Darijoo/Radargun/KiCad/Radargun.kicad_pcb

## KiCad design KiCad/Radargun.kicad_pcb (2026-06-18)

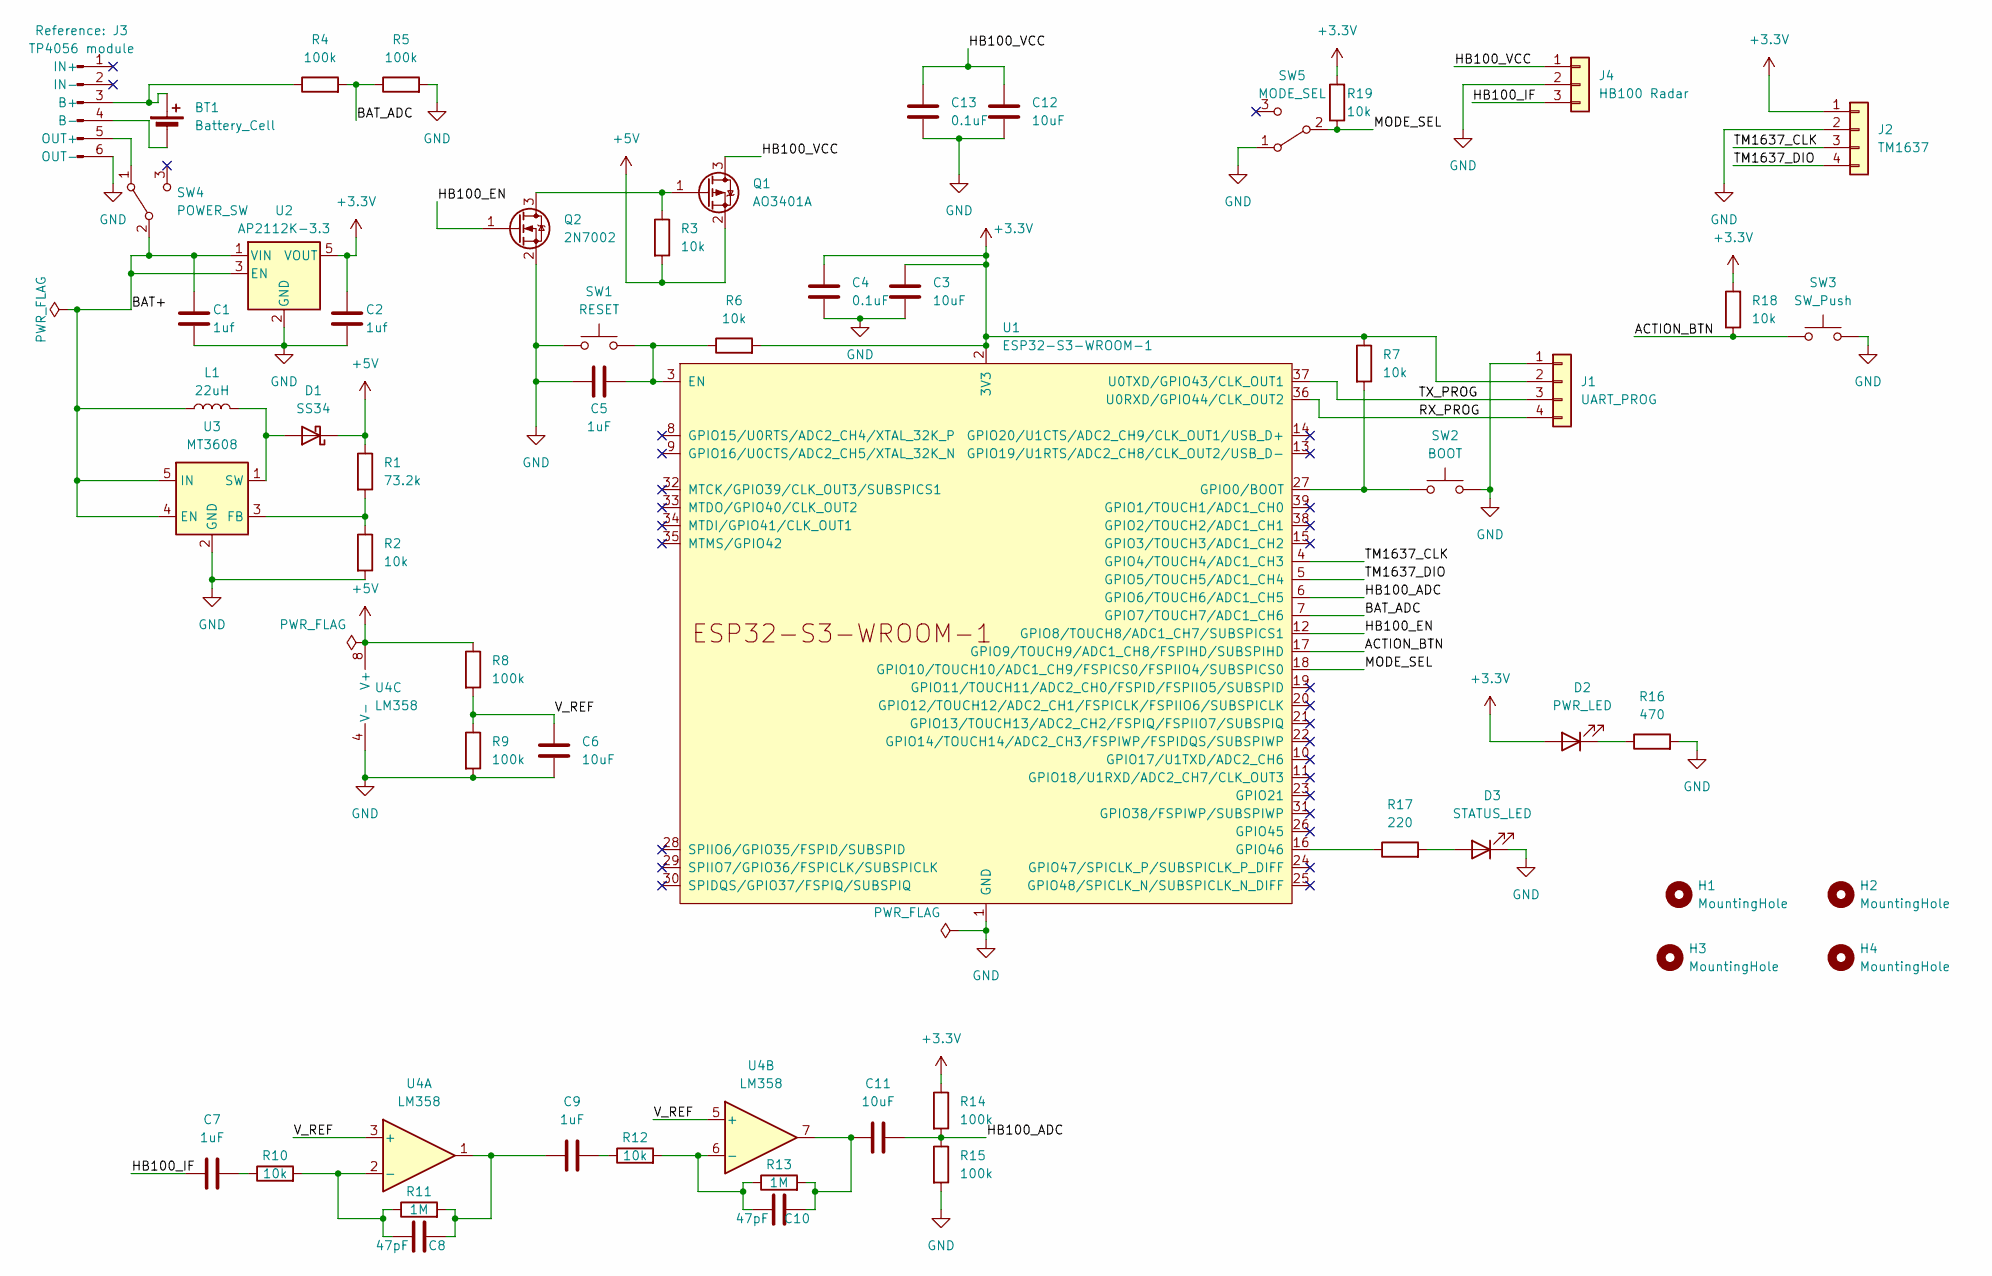
[picture p1: schematic Radargun.kicad_sch, Baseball Radar Gun]

Parts:
BT1: Battery_Cell; JST_PH_B2B-PH-K_1x02_P2.00mm_Vertical
C1, C2: 1uf; C_0805_2012Metric_Pad1.18x1.45mm_HandSolder
C3, C6, C11, C12: 10uF; C_0805_2012Metric_Pad1.18x1.45mm_HandSolder
C4, C13: 0.1uF; C_0805_2012Metric_Pad1.18x1.45mm_HandSolder
C5, C7, C9: 1uF; C_0805_2012Metric_Pad1.18x1.45mm_HandSolder
C8, C10: 47pF; C_0805_2012Metric_Pad1.18x1.45mm_HandSolder
D1: SS34; D_SMA
D2: PWR_LED; LED_0805_2012Metric_Pad1.15x1.40mm_HandSolder
D3: STATUS_LED; LED_0805_2012Metric_Pad1.15x1.40mm_HandSolder
H1, H2, H3, H4: MountingHole; MountingHole_3.2mm_M3
J1: UART_PROG; PinHeader_1x04_P2.54mm_Vertical
J2: TM1637; PinHeader_1x04_P2.54mm_Vertical
J3: TP4056 module; PinHeader_1x06_P2.54mm_Vertical
J4: HB100 Radar; PinHeader_1x03_P2.54mm_Vertical
L1: 22uH; L_1210_3225Metric_Pad1.42x2.65mm_HandSolder
Q1: AO3401A; SOT-23
Q2: 2N7002; SOT-23
R1: 73.2k; R_0805_2012Metric_Pad1.20x1.40mm_HandSolder
R2, R3, R6, R7, R10, R12, R18, R19: 10k; R_0805_2012Metric_Pad1.20x1.40mm_HandSolder
R4, R5, R8, R9, R14, R15: 100k; R_0805_2012Metric_Pad1.20x1.40mm_HandSolder
R11, R13: 1M; R_0805_2012Metric_Pad1.20x1.40mm_HandSolder
R16: 470; R_0805_2012Metric_Pad1.20x1.40mm_HandSolder
R17: 220; R_0805_2012Metric_Pad1.20x1.40mm_HandSolder
SW1: RESET; SW_PUSH_6mm
SW2: BOOT; SW_PUSH_6mm
SW3: SW_Push; SW_PUSH_6mm
SW4: POWER_SW; SS12D00
SW5: MODE_SEL; SS12D00
U1: ESP32-S3-WROOM-1
U2: AP2112K-3.3; SOT-23-5
U3: MT3608; SOT-23-6
U4: LM358; SOIC-8_3.9x4.9mm_P1.27mm

Connections:
+3.3V: C2.1, C3.1, C4.1, D2.2 (A), J1.2, J2.1, R6.2, R7.1, R14.1, R18.2, R19.2, U1.2 (3V3), U2.5 (VOUT)
+5V: D1.1 (K), Q1.2 (S), R1.1, R3.2, R8.1, U4.8 (V+)
/ACTION_BTN: R18.1, SW3.1, U1.17 (GPIO9/TOUCH9/ADC1_CH8/FSPIHD/SUBSPIHD)
/BAT+: C1.1, L1.1, SW4.2 (B), U2.1 (VIN), U2.3 (EN), U3.4 (EN), U3.5 (IN)
/BAT_ADC: R4.2, R5.1, U1.7 (GPIO7/TOUCH7/ADC1_CH6)
/HB100_ADC: C11.2, R14.2, R15.1, U1.6 (GPIO6/TOUCH6/ADC1_CH5)
/HB100_EN: Q2.1 (G), U1.12 (GPIO8/TOUCH8/ADC1_CH7/SUBSPICS1)
/HB100_IF: C7.1, J4.3
/HB100_VCC: C12.1, C13.1, J4.1, Q1.3 (D)
/MODE_SEL: R19.1, SW5.2 (B), U1.18 (GPIO10/TOUCH10/ADC1_CH9/FSPICS0/FSPIIO4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)
/RX_PROG: J1.4, U1.36 (U0RXD/GPIO44/CLK_OUT2)
/TM1637_CLK: J2.3, U1.4 (GPIO4/TOUCH4/ADC1_CH3)
/TM1637_DIO: J2.4, U1.5 (GPIO5/TOUCH5/ADC1_CH4)
/TX_PROG: J1.3, U1.37 (U0TXD/GPIO43/CLK_OUT1)
/V_REF: C6.1, R8.2, R9.1, U4.3 (+), U4.5 (+)
GND: C1.2, C2.2, C3.2, C4.2, C5.1, C6.2, C12.2, C13.2, D3.1 (K), J1.1, J2.2, J3.6 (OUT-), J4.2, Q2.2 (S), R2.2, R5.2, R9.2, R15.2, R16.2, SW1.1, SW2.2, SW3.2, SW5.1 (A), U1.1 (GND), U1.40 (GND), U1.41 (GND), U2.2 (GND), U3.2 (GND), U4.4 (V-)
unnamed: BT1.1 (+), J3.3 (B+), R4.1
unnamed: BT1.2 (-), J3.4 (B-)
unnamed: C7.2, R10.1
unnamed: C8.2, C9.1, R11.2, U4.1
unnamed: C9.2, R12.1
unnamed: C10.2, C11.1, R13.2, U4.7
unnamed: D1.2 (A), L1.2, U3.1 (SW)
unnamed: D2.1 (K), R16.1
unnamed: D3.2 (A), R17.2
unnamed: J3.5 (OUT+), SW4.1 (A)
unnamed: Q1.1 (G), Q2.3 (D), R3.1
unnamed: C5.2, R6.1, SW1.2, U1.3 (EN)
unnamed: R7.2, SW2.1, U1.27 (GPIO0/BOOT)
unnamed: R17.1, U1.16 (GPIO46)
unnamed: R1.2, R2.1, U3.3 (FB)
unnamed: C8.1, R10.2, R11.1, U4.2 (-)
unnamed: C10.1, R12.2, R13.1, U4.6 (-)

Board: 2 copper layers, 56 parts (0 on the bottom side), 33 nets, no tracks yet.
