Darijoo/Radargun/(commit log)

2026-06-03 Initial project setup
    [Radargun.kicad_pcb, Radargun.kicad_sch]
2026-06-03 Update BOM and Pinout for Power Management block
2026-06-03 Update BOM and Pinouts for ESP32 Core block
2026-06-03 Fix ESP32 physical pin numbers to GPIO names
2026-06-03 Update BOM and Pinouts for LM358 Analog Front-End
2026-06-04 Complete Phase 1 Schematic Capture (No ERC errors)
    [Radargun.kicad_sch]
2026-06-04 Add final pre-flight safety net components and switches
2026-06-05 Add safety net components to KiCad schematic
    [Radargun.kicad_sch]
2026-06-10 Start design PCB Layout
    [Radargun.kicad_sch]
2026-06-17 PCB layout guide added
    [Radargun.kicad_pcb, Radargun.kicad_sch]
2026-06-18 PCB placement update
    [Radargun.kicad_pcb]
